minchien-hub/doan_phanloairac1/baocao.docx

MỞ ĐẦU

Trong bối cảnh đô thị hóa và công nghiệp hóa diễn ra mạnh mẽ, lượng rác thải sinh hoạt phát sinh mỗi ngày tại các đô thị lớn là rất lớn. Việc phân loại rác thải tại nguồn đóng vai trò then chốt trong việc giảm tải áp lực cho môi trường, tối ưu hóa quá trình tái chế và xử lý rác. Tuy nhiên, tại Việt Nam, thói quen phân loại rác tại nguồn của người dân vẫn chưa cao, còn mang tính tự phát và thiếu các giải pháp công nghệ hỗ trợ tự động hóa hiệu quả.

Xuất phát từ thực tiễn đó, việc nghiên cứu và chế tạo một hệ thống thông minh hỗ trợ phân loại rác tự động kết hợp giám sát từ xa là vô cùng cần thiết. Đề tài "Thiết kế và thi công hệ thống phân loại rác thải tự động tại nguồn ứng dụng Edge AI và IoT" được thực hiện nhằm ứng dụng các thuật toán thị giác máy tính (Computer Vision) và trí tuệ nhân tạo tại biên (Edge AI) trên nền tảng máy tính nhúng Raspberry Pi 4 kết hợp vi điều khiển ESP32. Hệ thống không chỉ tự động nhận diện và điều hướng rác vào đúng ngăn chứa ngay tại thời điểm người dùng bỏ rác, mà còn giám sát mức độ đầy của từng ngăn chứa theo thời gian thực thông qua cơ sở dữ liệu đám mây Firebase Realtime Database và ứng dụng di động, góp phần nâng cao ý thức cộng đồng và hiện đại hóa công tác quản lý môi trường đô thị.

CHƯƠNG 1. TỔNG QUAN ĐỀ TÀI

1.1. LÝ DO CHỌN ĐỀ TÀI

Thực trạng vấn đề rác thải: Rác thải sinh hoạt ngày càng gia tăng cả về số lượng lẫn chủng loại phức tạp (nhựa, giấy, kim loại, thức ăn thừa, rác thải nguy hại/điện tử). Việc thu gom và xử lý hỗn hợp các loại rác này gây lãng phí tài nguyên tái chế và làm trầm trọng thêm tình trạng ô nhiễm môi trường.

Hạn chế của việc phân loại thủ công và quản lý truyền thống: Ý thức phân loại rác tại nguồn của một bộ phận người dân chưa cao; việc hướng dẫn phân loại bằng bảng hiệu hay đặt các thùng rác nhiều ngăn thông thường vẫn dẫn đến tình trạng bỏ nhầm ngăn. Bên cạnh đó, nhân viên thu gom khó nắm bắt được thời điểm nào từng ngăn rác đã đầy mà không đi kiểm tra trực tiếp.

Tiềm năng của công nghệ Edge AI và IoT: Sự phát triển mạnh mẽ của Thị giác máy tính và Học sâu (Deep Learning), đặc biệt là các mô hình nhận diện vật thể thời gian thực như YOLO, kết hợp với các bo mạch nhúng nhỏ gọn như Raspberry Pi 4 và ESP32 tạo ra cơ hội lớn để tự động hóa hoàn toàn quy trình phân loại rác tại thiết bị biên (Edge AI). Đồng thời, việc tích hợp nền tảng đám mây Firebase và ứng dụng di động giúp số hóa hoàn toàn việc theo dõi trạng thái thùng rác từ xa.

1.2. MỤC ĐÍCH NGHIÊN CỨU ĐỀ TÀI

Nghiên cứu, xây dựng và làm chủ quy trình kết hợp giữa xử lý ảnh số cổ điển (Classical 2D Image Processing) và mạng nơ-ron học sâu (Deep Learning) triển khai trên hệ thống nhúng phục vụ đời sống.

Thiết kế mô hình thùng rác thông minh có khả năng tự động phát hiện vật thể trên khay tiếp nhận, nhận diện chủng loại và điều khiển cơ cấu cơ khí đưa rác vào đúng ngăn chứa mà không cần sự can thiệp phân loại của con người.

Xây dựng hệ sinh thái IoT hoàn chỉnh giúp đồng bộ thông số khoảng cách và phần trăm dung lượng của các ngăn chứa rác lên đám mây, hỗ trợ người quản lý giám sát trực tuyến qua ứng dụng điện thoại thông minh.

1.3. MỤC TIÊU NGHIÊN CỨU ĐỀ TÀI

Về phần mềm (Thị giác máy tính & Edge AI):

Xây dựng thuật toán tiền xử lý ảnh trên OpenCV (sử dụng bộ lọc trung vị Median, trừ nền nhận diện chuyển động, phân ngưỡng tự động Otsu, phép toán hình thái học và trích xuất vùng liên thông Connected Components) để tự động phát hiện và cắt vùng chứa vật thể rác (ROI) trên khay nhận diện.

Huấn luyện và tối ưu hóa mô hình YOLO (xuất sang định dạng ONNX) để phân loại rác thành 4 nhóm chuẩn: Rác hữu cơ (organic), Rác tái chế (recycle), Rác khó phân hủy/không tái chế (non_recycle), và Rác nguy hại (hazardous).

Đảm bảo mô hình hoạt động ổn định trong điều kiện thực tế với các chỉ số đánh giá (Precision, Recall, mAP và Confusion Matrix) đạt hiệu suất cao, thời gian suy luận (inference time) nhanh đáp ứng yêu cầu thời gian thực trên Raspberry Pi 4.

Về phần cứng & Hệ thống nhúng:

Sử dụng Raspberry Pi 4 kết hợp Camera làm trung tâm thu thập hình ảnh, chạy thuật toán tách nền, suy luận mô hình AI và truyền lệnh điều khiển qua giao thức UART.

Sử dụng vi điều khiển ESP32 làm bộ điều khiển ngoại vi: nhận lệnh UART từ Raspberry Pi để điều khiển động cơ bước NEMA17 (thông qua driver A4988) xoay phễu dẫn hướng tới đúng góc của 4 ngăn chứa (45°, 135°, -135°, -45°), đồng thời điều khiển 2 động cơ Servo thực hiện quy trình mở chốt khóa và mở cửa sập xả rác tự động.

Tích hợp 4 cảm biến siêu âm HC-SR04 trên ESP32 để đo khoảng cách rác thực tế trong từng ngăn, tự động tính toán phần trăm mức đầy và phân loại trạng thái (NORMAL, WARNING, FULL).

Về hệ thống IoT & Ứng dụng di động:

Thiết lập cơ sở dữ liệu thời gian thực Firebase Realtime Database để lưu trữ và đồng bộ liên tục trạng thái của 4 ngăn rác từ ESP32 qua kết nối Wi-Fi.

Xây dựng ứng dụng di động đa nền tảng bằng React Native (Expo) kết nối trực tiếp với Firebase, hiển thị trực quan thanh tiến trình phần trăm mức đầy, dung lượng còn lại và cảnh báo màu sắc theo thời gian thực (Live).

Về cơ khí:

Thiết kế và chế tạo mô hình thùng rác thông minh 4 ngăn hoàn chỉnh (chiều cao ngăn chứa 45 cm, khoảng cách từ cảm biến đến đáy thùng 55 cm), đảm bảo cơ cấu xoay và cửa xả hoạt động trơn tru, chính xác.

1.4. ĐỐI TƯỢNG VÀ PHẠM VI NGHIÊN CỨU

Đối tượng nghiên cứu:

Các thuật toán tiền xử lý ảnh 2D, phân đoạn vật thể và mô hình học sâu nhận diện đối tượng YOLO tối ưu cho thiết bị biên (ONNX Runtime).

Kỹ thuật lập trình vi điều khiển ESP32, máy tính nhúng Raspberry Pi, giao tiếp nối tiếp UART và điều khiển động cơ bước/servo.

Cơ sở dữ liệu đám mây Firebase Realtime Database và phát triển ứng dụng di động với React Native.

Phạm vi nghiên cứu:

Hệ thống tập trung nhận diện và phân loại 4 nhóm rác sinh hoạt phổ biến (organic, recycle, non_recycle, hazardous) với kịch bản bỏ từng món rác đơn lẻ vào khay tiếp nhận có nền tiêu chuẩn.

Triển khai và kiểm thử trên mô hình thực nghiệm đặt tại môi trường trong nhà, trường học, văn phòng hoặc khu vực công cộng có mái che và kết nối mạng Wi-Fi.

1.5. PHƯƠNG PHÁP NGHIÊN CỨU

Phương pháp nghiên cứu lý thuyết:

Tổng hợp tài liệu khoa học về thị giác máy tính, nghiên cứu cơ sở toán học của các bộ lọc phi tuyến, phân ngưỡng tự động, hình thái học và kiến trúc mạng nơ-ron tích chập (CNN/YOLO).

Nghiên cứu tài liệu kỹ thuật (datasheet) của vi điều khiển ESP32, Raspberry Pi 4, driver A4988, cảm biến siêu âm HC-SR04 và tài liệu tích hợp SDK của Firebase/React Native.

Phương pháp nghiên cứu thực nghiệm:

Thu thập, tiền xử lý, tăng cường dữ liệu (Data Augmentation) và huấn luyện bộ dữ liệu gần 25.000 ảnh trên nền tảng đám mây kết hợp máy tính cá nhân, sau đó trích xuất trọng số tối ưu để chuyển đổi sang định dạng ONNX.

Thực nghiệm tinh chỉnh các thông số tách nền và ngưỡng độ tin cậy (Confidence Threshold) của mô hình AI dưới các góc đặt rác và điều kiện ánh sáng thực tế trên khay chứa.

Thi công mạch điện, lắp ráp khung cơ khí, lập trình nhúng cho ESP32/Raspberry Pi, xây dựng giao diện ứng dụng di động và tiến hành kiểm thử tích hợp toàn hệ thống (Integration Testing).

1.6. BỐ CỤC ĐỒ ÁN

Nội dung cuốn báo cáo được tổ chức thành 5 chương như sau:

Chương 1: Tổng quan đề tài – Trình bày lý do chọn đề tài, mục đích, mục tiêu, đối tượng, phạm vi và phương pháp nghiên cứu.

Chương 2: Cơ sở lý thuyết – Trình bày nền tảng lý thuyết về xử lý ảnh số, mạng học sâu nhận diện vật thể YOLO, tổng quan về phần cứng nhúng (Raspberry Pi, ESP32, động cơ, cảm biến) và công nghệ IoT (Firebase, React Native).

Chương 3: Phân tích và thiết kế hệ thống – Trình bày sơ đồ khối tổng thể, thiết kế phần cứng cơ khí, sơ đồ đấu nối chân và lưu đồ giải thuật trên Raspberry Pi, ESP32 và ứng dụng di động.

Chương 4: Triển khai và xây dựng hệ thống – Mô tả chi tiết quá trình huấn luyện mô hình AI, lập trình phần mềm nhúng, thiết lập cấu trúc Firebase Realtime Database và xây dựng giao diện ứng dụng giám sát.

Chương 5: Thực nghiệm, đánh giá và kết luận – Trình bày kết quả thi công thực tế, bảng số liệu kiểm thử độ chính xác nhận diện rác, độ ổn định của cảm biến siêu âm, đồng thời rút ra kết luận và hướng phát triển của đề tài.
