minchien-hub/doan_phanloairac1/(commit log)

2026-11-05 Cap nhat logic nut thu gom: luon cho phep bam ghi nhan nhat ky ngay ca khi 0%
2026-11-05 Remove done button from dashboard, remove firebase records subtitle and update notifications filter to individual stations
2026-11-05 Bind alerts and statistics strictly to real hardware sync (Sảnh Tòa A) sensor data
2026-11-10 Fix station card tap to open IoT monitor screen with live camera and sensor parameters
2026-11-10 Remove fill level percentage from hardware distance section and enable rapid switching between lobby chips
2026-11-10 Auto-detect ONLINE status when hardware sensors publish to Firebase and sync esp.ino status node
2026-11-13 Update station detail monitoring screen with threshold stepper, waste overview, accordions for AI camera, door servo, sensors and collection history
